Ziemniaczenka/OptiBolt-protocol-and-evaluation/doc/resources/protokół komunikacji teoria.pdf

Pamiętać że będziemy używać manchester czyli każde 0 w tym pliku to tak naprawde 01 a każde 1 to tak naprawde 10
idle: docelowo 111111, ale dekoder może sie pogubić i odbierać to jako 000000, nie ma to dla nas znaczenia bo istnieje preambuła
preambuła+bity start (6+2 bitów) 01010100
header (3 bity)
Handshake: fizyczny switch na płytce czy jest źródłem czy odbiornikiem, jeśli łączą sie 2 te same typy - przerwanie łączności.
000 - Capabilities (co ma źródło)
001 - Request (co chce odbiornik)
010 - Accept (zgoda źródła)
011 - Denied (odmowa źródła) Dane użytkowe:
100 - tekst
101 - test1
110 - test2
111 - test3
dane (8 bitów)
Handshake:
chce/daje np
0000 0001 5V 1A
0000 0010 9V 2A
0000 0100 20V 5A
Można również początkowe bity zaimplementować do negocjacji częstotliwości
Dane użytkowe:
użytkownik jest w stanie wpisać całe zdanie i potem wysyłamy to literka po literce w kodzie ASCII bit parzystości (1 bit) 0 jeśli liczba 1 parzysta, 1 jeśli nieparzysta
bit stopu (1 bit) po prostu 1
synchronizacja przy każdym bitcie bo mamy oversampling 16x, zbocze zawsze powinno być w połowie, jak nie to korygujemy
sprawdzamy w 0.2 trwania bitu i w 0.8 trwania bitu, jak mamy 1 i 0 to znaczy że 1 jak mamy 0 i 1 to znaczy że 0, jak mamy 1 i 1 albo 0 i 0 to oznacza błąd i przerwanie nadawania. Dodatkowo sprawdzamy kiedy było zbocze użytkowe które miało być około 0.5, tam gdzie ono było to jest nasze nowe 0.5
