Ziemniaczenka/OptiBolt-protocol-and-evaluation/doc/resources/raport.docx

# Tytuł: OptiBolt - Hybrydowy protokół komunikacji optycznej i platforma ewaluacyjna Autorzy: Tomasz Więcławski (TW), Sebastian Zoń (SZ)

Ostatnia modyfikacja: 30.08.2026

Spis treści

1. Repozytorium git 1

2. Wstęp 1

3. Specyfikacja 1

3.1. Opis ogólny algorytmu 1

3.2. Tabela zdarzeń 2

4. Architektura 2

4.1. Moduł: top 2

4.1.1. Schemat blokowy 2

4.1.2. Porty 3

a) mou – mouse_ctl, input 3

b) vga – vga_ctl, output 3

4.1.3. Interfejsy 3

a) m2c – mouse_ctl to core 3

4.2. Rozprowadzenie sygnału zegara 3

5. Implementacja 4

5.1. Lista zignorowanych ostrzeżeń Vivado. 4

5.2. Wykorzystanie zasobów 4

5.3. Marginesy czasowe 4

6. Film. 4

# 1. Repozytorium git

Adres repozytorium GITa:

https://github.com/Ziemniaczenka/OptiBolt-protocol-and-evaluation

W przypadku repozytorium prywatnego należy zaprosić użytkownika zewnętrznego o adresie mailowym: kaczmarczyk@agh.edu.pl

# 2. Wstęp

Celem projektu jest zaprojektowanie, implementacja i weryfikacja hybrydowego protokołu komunikacji optyczno-elektrycznej OptiBolt oraz kompletnej platformy ewaluacyjnej na układach FPGA Digilent Basys 3 (Xilinx Artix-7 XC7A35T). Protokół wykorzystuje optyczne transceivery TOSLINK (PMOD) do bezbłędnej transmisji danych o wysokiej odporności na zakłócenia elektromagnetyczne (EMI) i pełnej izolacji galwanicznej. Platforma ewaluacyjna integruje sprzętowy kontroler wideo VGA (720p 1280x720@60Hz), dekoder klawiatury USB/PS-2, interaktywne menu ekranowe, terminal CLI, testy integralności sygnału (BER, latency RTT, sweep przepływności), przesyłanie bitmap oraz emulację negocjacji zasilania (Power Delivery).

# 3. Specyfikacja

## 3.1. Opis ogólny algorytmu

Transceiver protokołu OptiBolt pracuje w domenie 200 MHz, co zapewnia precyzyjne próbkowanie (oversampling) i kodowanie sygnału w kodzie Manchester (samotaktujący strumień danych). Ramka protokołu składa się z 8-bitowej preambuły synchronizującej, 3-bitowego typu komunikatu (Dane, Komenda, Negocjacja Zasilania, Ping), 8-bitowego ładunku danych oraz bitu parzystości. Odbiornik dokonuje detekcji nośnej optycznej, synchronizacji fazowej, weryfikacji kodu Manchester oraz kontroli integralności danych. Platforma ewaluacyjna w domenie 100 MHz steruje wykonywaniem testów automatycznych, analizą błędów w czasie rzeczywistym i wyświetlaniem wyników na ekranie.

Ewentualnie przykładowe screen-shoty tego, co w przybliżeniu chcielibyśmy uzyskać.

## 3.2. Tabela zdarzeń

Opis zdarzeń występujących podczas działania programu/urządzenia, zarówno zewnętrznych (interakcje z użytkownikiem), jak i wewnętrznych (specyficzne stany w algorytmie). Zdarzenia podzielone są na kategorie dotyczące różnych stanów działania programu. Kategorie powinny odpowiadać stanom ze schematu z pkt. 2.1.

Zdarzenie | Kategoria | Reakcja systemu
Naciśnięcie strzałek (Góra/Dół/Lewo/Prawo) | Nawigacja UI | Przemieszczenie wskaźnika zaznaczenia po przyciskach paska narzędzi i polach ekranu.
Naciśnięcie Enter na przycisku Toolbar | Nawigacja UI | Uruchomienie wybranej funkcji (np. Help, Ping, Sweep, Send BMP, Clear Console/BMP).
Wpisanie tekstu i Enter w polu CLI | Terminal CLI | Przekazanie linii poleceń do interpretera, wykonanie komendy lub wysłanie wiadomości tekstowej do drugiej płytki.
Odebranie pakietu Ping Request | Protokół OptiBolt | Automatyczne wygenerowanie i odesłanie pakietu Ping Response w warstwie sprzętowej.
Odebranie pakietu Ping Response | Ewaluacja | Zatrzymanie licznika czasu, obliczenie czasu Round-Trip Time (RTT) w cyklach/mikrosekundach i wypisanie wyniku w konsoli.
Uruchomienie testu Sweep | Testy protokołu | Automatyczne przejście przez wszystkie kombinacje Baudrate i Oversampling, transmisja pakietów testowych i weryfikacja poprawności.
Wysłanie bitmapy 64x64 | Transfer danych | Odczyt pikseli z pamięci obrazu, sekwencyjna transmisja pakietów graficznych przez łącze optyczne i wizualizacja na ekranie odbiorcy.
Wykrycie zaniku/pojawienia nośnej optycznej | Warstwa fizyczna | Aktualizacja stanu diody nośnej (Carrier Detect) oraz powiadomienie modułu nadrzędnego o stanie łącza.
Wykrycie błędu (Manchester / Parzystość / Preambuła) | Diagnostyka | Inkrementacja dedykowanych liczników błędów, aktualizacja wskaźników paskowych i wyliczenie współczynnika BER.

# 4. Architektura

Uwaga: dobrze zrobiony projekt zawiera tylko moduły strukturalne (zbudowane z innych modułów) i funkcjonalne (zawierające bloki proceduralne always @). Staramy się nie generować bloków mieszających te dwa typy, o ile to możliwe (głównym kryterium powinna być czytelność kodu).

Uwaga: opisujemy architekturę tylko głównego modułu oraz rozprowadzenie sygnału zegara.

## 4.1. Moduł: top

Osoba odpowiedzialna: Tomasz Więcławski, Sebastian Zoń

### 4.1.1. Schemat blokowy

Uwaga: Schemat blokowy to nie jest schemat z Vivado! Nie zawiera on sygnałów, tylko interfejsy. Interfejs oznacza tutaj grupę sygnałów. Schemat blokowy pokazuje moduły składowe, oraz łączące je interfejsy.

Architektura modułu głównego (top.sv) integruje cztery kluczowe bloki funkcjonalne:
1. u_top_evaluation – platforma ewaluacyjna (GUI VGA 720p, PS/2, kontroler ewaluacji, pamięci BRAM),
2. u_optibolt_controller – kontroler protokołu (generator taktowania, koder/dekoder Manchester, kolejki FIFO TX/RX),
3. u_optibolt_cdc_bridge – bezpieczny most asynchroniczny (CDC) łączący domenę ewaluacji 100 MHz i domenę protokołu 200 MHz,
4. u_optical_carrier_detector – sprzętowy detektor obecności nośnej na linii optycznej RX z filtrem histerezy.
Szczegółowe schematy blokowe w formacie Mermaid znajdują się w plikach doc/schematic/top_schematic.mmd oraz doc/schematic/hardware_schematic.mmd.

Uwaga:

- interfejsy dwukierunkowe rozbijamy na 2 interfejsy jednokierunkowe
- nazwa interfejsu stanowi prefiks nazwy sygnałów składowych
- w interfejsach nie uwzględniamy sygnałów globalnych (np. clk i rst).

### 4.1.2. Porty

#### a) mou – mouse_ctl, input

nazwa portu | opis
clk | Zegar wejściowy 100 MHz z oscylatora płytki Basys 3
btnC | Przycisk resetu asynchronicznego (aktywny w stanie wysokim, negowany wewnętrznie na rst_n)
JB3 | Wejście szeregowe RX z odbiornika optycznego TOSLINK (PMOD JB, pin B15)
PS2Clk | Linia zegarowa dwukierunkowej szyny klawiatury PS/2 (z buforem trójstanowym)
PS2Data | Linia danych dwukierunkowej szyny klawiatury PS/2 (z buforem trójstanowym)

#### b) vga – vga_ctl, output

nazwa portu | opis
JB1 | Wyjście szeregowe TX do nadajnika optycznego TOSLINK (PMOD JB, pin A14)
Vsync, Hsync | Sygnały synchronizacji pionowej i poziomej standardu VGA 720p
vgaRed[3:0], vgaGreen[3:0], vgaBlue[3:0] | 12-bitowa cyfrowa szyna kolorów RGB przetwornika rezystorowego VGA
seg[6:0], an[3:0], dp | Sygnały sterujące 4-pozycyjnym 7-segmentowym wyświetlaczem LED
JA1 | Wyjście diagnostyczne lustrzanego zegara pikseli (PMOD JA)

### 4.1.3. Interfejsy

#### a) m2c – mouse_ctl to core

nazwa sygnału | opis
eval2cdc_tx_data[7:0] | Bajt danych nadawanych z platformy ewaluacyjnej do mostka CDC (100 MHz)
eval2cdc_tx_type[2:0] | Typ pakietu nadawczego (DATA, REQUEST, POWER, PING)
eval2cdc_tx_valid / full | Sygnały sterujące zapisem do asynchronicznej kolejki FIFO nadajnika
cdc2eval_rx_data[7:0] | Odebrany bajt danych przekazany z mostka CDC do ewaluacji (100 MHz)
cdc2eval_rx_type[2:0] | Typ odebranego pakietu
cdc2eval_rx_valid | Flaga ważności odebranego bajtu (strob 1-cyklowy w domenie 100 MHz)
cdc2eval_err_flags | Rozciągnięte i zsynchronizowane impulsy błędów (Manchester, Parity, Preamble)
vga_if (vcount, hcount, vsync, hsync, vblnk, hblnk, rgb) | Standaryzowany interfejs potoku generacji i nakładania warstw obrazu VGA
bram_if (addr, en, we, din, dout) | Interfejsy pamięci RAM/ROM dla bufora konsoli, czcionki, bitmapy i etykiet

## 4.2. Rozprowadzenie sygnału zegara

Osoba odpowiedzialna: Tomasz Więcławski, Sebastian Zoń

W projekcie zastosowano trzy synchronicznie powiązane domeny zegarowe wygenerowane z wbudowanych układów MMCM (Clocking Wizard):
1. 100.000 MHz (clk100) – główny zegar systemowy platformy ewaluacyjnej, kontrolera UI, konsoli i interfejsu PS/2 (wygenerowany przez clk_wiz_0),
2. 200.000 MHz (clk200) – zegar o wysokiej częstotliwości dedykowany dla transceivera OptiBolt, zapewniający precyzyjne taktowanie oversamplingu i koderów Manchester (wygenerowany przez clk_wiz_0),
3. 74.250 MHz (clk74p25) – zegar pikseli (pixel clock) zgodny ze standardem VESA 720p @ 60Hz (1280x720, wygenerowany przez clk_wiz_1).
Pomiędzy domenami 100 MHz i 200 MHz zastosowano sprzętowy mostek asynchroniczny CDC (podwójne synchronizatory cdc_sync oraz asynchroniczne kolejki async_fifo oparte na kodzie Graya).

Moduł generatora zegara umieszczamy w module głównym projektu. W pozostałych modułach używamy tylko i wyłącznie sygnały zegara wygenerowane przez ten moduł.

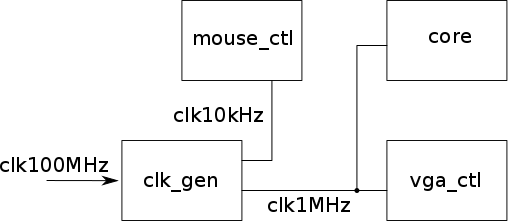
[picture p7: figure]

Uwaga: jeżeli używamy różnych częstotliwości zegara w układzie, to należy je tak dobrać, aby były wielokrotnościami siebie (umożliwia to wygenerowanie tych sygnałów z jednego IP core generatora zegara i zapobiega problemom z synchronizacją).

# 5. Implementacja

## 5.1. Lista zignorowanych ostrzeżeń Vivado.

Identyfikator ostrzeżenia | Liczba wystąpień | Uzasadnienie
Synth 8-7129 | 100 | Warning dotyczy nieużywanych portów/linii w modułach podłączonych do ustandaryzowanych interfejsów SystemVerilog (vga_if, bram_if, sampling_tick_generator). Interfejsy te grupują pełen zestaw sygnałów (koordynaty, synchronizacja, szyny danych BRAM). Poszczególne moduły wykonawcze (np. draw_string, draw_rect, draw_mux) subskrybują jedynie ten podzbiór sygnałów, który jest niezbędny do realizacji ich dedykowanej funkcji. Nieużywane linie magistrali są w sposób zamierzony i bezpieczny optymalizowane przez syntezę.
Synth 8-6014 | 26 | Rejestry buforów historii poleceń CLI oraz niewykorzystane bity struktur RAM zostały zoptymalizowane w procesie syntezy logicznej jako martwy kod (dead-code elimination). Pojemność struktur pamięciowych została zadeklarowana z marginesem na rozwój protokołu, a niewykorzystywane obszary nie generują zbędnych przerzutników.
Synth 8-3332 | 4 | Vendorowy moduł obsługi interfejsu klawiatury (Ps2Interface.vhd firmy Digilent) zawiera stany automatu FSM dedykowane do dwukierunkowej transmisji z urządzeniem PS/2. W niniejszym projekcie klawiatura pracuje wyłącznie w trybie jednokierunkowego odbioru skan-kodów (simplex RX), w związku z czym nieosiągalne stany nadawcze FSM zostały poprawnie usunięte przez syntezator.
Synth 8-5835 | 1 | Projekt deklaruje liczne tablice pamięci (bufory tekstu konsoli, czcionki ASCII, tablice parametrów). Wstępna alokacja zasobów BRAM przewyższyła dostępną liczbę dedykowanych bloków Block RAM w układzie XC7A35T (130/100). Syntezator Vivado automatycznie dokonał konwersji mniejszych pamięci stałych (ROM) do pamięci rozproszonej Distributed LUT-RAM, co pozwoliło w pełni zmieścić projekt w dostępnych zasobach FPGA.
Synth 8-330 | 25 | Interfejsy SystemVerilog (bram_if) przekazywane do modułów podrzędnych bez jawnego modportu domyślnie wnioskują połączenia dwukierunkowe (inout). Vivado poprawnie trasuje rzeczywiste kierunki przepływu danych na podstawie sterowników w modułach podrzędnych.
Opt 31-35 | 1 | Dotyczy usunięcia redundantnego bufora wejściowego IBUF z instancji clk_wiz_0. Sygnał zegarowy z pinu clk jest buforowany na poziomie top_basys3, a Vivado automatycznie eliminuje kaskadowy bufor wewnętrzny.
Power 33-332 | 1 | Wektorowa analiza poboru mocy (narzędzie Vivado Report Power) informuje o domyślnym przyjęciu stałej aktywności sygnału asynchronicznego resetu rst_n. Ostrzeżenie ma charakter czysto informacyjny dotyczący dokładności szacowania poboru mocy i nie wpływa na poprawność działania ani timingi układu FPGA.

## 5.2. Wykorzystanie zasobów

Wykorzystanie zasobów układu FPGA Xilinx Artix-7 (XC7A35T-CPG236-1) po pełnej implementacji:
• Slice LUTs: 19 927 / 20 800 (95.80%)
- LUT jako logika: 19 175 / 20 800 (92.19%)
- LUT jako Distributed RAM: 752 / 9 600 (7.83%)
• Slice Registers (Flip-Flops): 9 221 / 41 600 (22.17%)
• Block RAM (RAMB36E1/RAMB18E1): 45 / 50 płytek (90.0%)
• Układy zegarowe MMCM / PLL: 2 / 5 (40.0%)
• Bufory zegarowe (BUFG / BUFGCE): 5 / 32 (15.63%)
• Linie wejścia/wyjścia (User I/O): 28 / 106 (26.42%)

## 5.3. Marginesy czasowe

Wyniki statycznej analizy czasowej (Static Timing Analysis) po pełnym trasowaniu (Route Design):
• Setup Time Slack (WNS – Worst Negative Slack): +0.265 ns (TNS = 0.000 ns – brak naruszeń czasowych setup)
• Hold Time Slack (WHS – Worst Hold Slack): +0.020 ns (THS = 0.000 ns – brak naruszeń czasowych hold)
• Pulse Width Slack (WPWS): +1.250 ns (TPWS = 0.000 ns)
Wszystkie zdefiniowane ograniczenia czasowe dla domen 100 MHz, 200 MHz i 74.25 MHz zostały w pełni spełnione (Timing Constraints Met).

# 6. Konfiguracja sprzętu

Konfiguracja sprzętowa zestawu:
1. Połączenie optyczne: Połączenie dwóch płytek Basys 3 za pomocą dwóch przewodów światłowodowych TOSLINK (transmisja pełnodupleksowa Full-Duplex):
- Płytka 1 PMOD JB (JB1: TX) -> Światłowód 1 -> Płytka 2 PMOD JB (JB3: RX)
- Płytka 2 PMOD JB (JB1: TX) -> Światłowód 2 -> Płytka 1 PMOD JB (JB3: RX)
2. Wyświetlanie obrazu: Podłączenie monitora HDMI/VGA przez port VGA do wyjścia 720p.
3. Wprowadzanie danych: Klawiatura podłączona do portu USB HID (obsługiwana przez wbudowany kontroler PS/2).

Schematy podłączenia dodatkowych urządzeń peryferyjnych.

Konfiguracja zworek, przełączników, itp., jeśli inna niż domyślna.

# 7. Film.

Link do ściągnięcia filmu:

https://

MTM UEC2 14.04.2026 Raport z projektu, v.1.0.1 4 / 4
