Ziemniaczenka/OptiBolt-protocol-and-evaluation/doc/resources/raport_template_2025.docx

# Tytuł: OptiBolt - protocol and testbench Autorzy: Tomasz Więcławski (TW), Sebastian Zoń (SZ)

Ostatnia modyfikacja: 14.04.2026

Spis treści

1. Repozytorium git 1

2. Wstęp 1

3. Specyfikacja 1

3.1. Opis ogólny algorytmu 1

3.2. Tabela zdarzeń 2

4. Architektura 2

4.1. Moduł: top 2

4.1.1. Schemat blokowy 2

4.1.2. Porty 3

a) mou – mouse_ctl, input 3

b) vga – vga_ctl, output 3

4.1.3. Interfejsy 3

a) m2c – mouse_ctl to core 3

4.2. Rozprowadzenie sygnału zegara 3

5. Implementacja 4

5.1. Lista zignorowanych ostrzeżeń Vivado. 4

5.2. Wykorzystanie zasobów 4

5.3. Marginesy czasowe 4

6. Film. 4

# 1. Repozytorium git

Adres repozytorium GITa:

https://

W przypadku repozytorium prywatnego należy zaprosić użytkownika zewnętrznego o adresie mailowym: kaczmarczyk@agh.edu.pl

# 2. Wstęp

Skąd się wziął pomysł i co w ramach tego projektu robimy.

# 3. Specyfikacja

## 3.1. Opis ogólny algorytmu

Uproszczony schemat blokowy działania implementowanego algorytmu. Co się dzieje po starcie, jak wygląda przebieg działania, kiedy i pod jakimi warunkami się kończy.

Ewentualnie przykładowe screen-shoty tego, co w przybliżeniu chcielibyśmy uzyskać.

## 3.2. Tabela zdarzeń

Opis zdarzeń występujących podczas działania programu/urządzenia, zarówno zewnętrznych (interakcje z użytkownikiem), jak i wewnętrznych (specyficzne stany w algorytmie). Zdarzenia podzielone są na kategorie dotyczące różnych stanów działania programu. Kategorie powinny odpowiadać stanom ze schematu z pkt. 2.1.

Zdarzenie | Kategoria | Reakcja systemu
LPM w obszarze X | Ekran startowy | Uruchomienie gry
Piłka uderza w ścianę | Gra | Zmiana kierunku ruchu piłki
Piłka uderza w dół ekranu | Gra | Koniec gry

# 4. Architektura

Uwaga: dobrze zrobiony projekt zawiera tylko moduły strukturalne (zbudowane z innych modułów) i funkcjonalne (zawierające bloki proceduralne always @). Staramy się nie generować bloków mieszających te dwa typy, o ile to możliwe (głównym kryterium powinna być czytelność kodu).

Uwaga: opisujemy architekturę tylko głównego modułu oraz rozprowadzenie sygnału zegara.

## 4.1. Moduł: top

Osoba odpowiedzialna: JK

### 4.1.1. Schemat blokowy

Uwaga: Schemat blokowy to nie jest schemat z Vivado! Nie zawiera on sygnałów, tylko interfejsy. Interfejs oznacza tutaj grupę sygnałów. Schemat blokowy pokazuje moduły składowe, oraz łączące je interfejsy.

Miejsce na schemat blokowy modułu głównego

Uwaga:

- interfejsy dwukierunkowe rozbijamy na 2 interfejsy jednokierunkowe
- nazwa interfejsu stanowi prefiks nazwy sygnałów składowych
- w interfejsach nie uwzględniamy sygnałów globalnych (np. clk i rst).

### 4.1.2. Porty

#### a) mou – mouse_ctl, input

nazwa portu | opis
mou_si | szeregowe wejście danych

#### b) vga – vga_ctl, output

nazwa portu | opis
vga_vs | sygnał synchronizacji pionowej VGA

### 4.1.3. Interfejsy

#### a) m2c – mouse_ctl to core

nazwa sygnału | opis
m2c_x[9:0] | horyzontalna pozycja kursora myszy na ekranie
m2c_y[9:0] | wertykalna pozycja kursora myszy na ekranie

## 4.2. Rozprowadzenie sygnału zegara

Osoba odpowiedzialna: JK

Informacja na temat źródła sygnału zegarowego, używanych częstotliwości zegara w całym układzie.

Moduł generatora zegara umieszczamy w module głównym projektu. W pozostałych modułach używamy tylko i wyłącznie sygnały zegara wygenerowane przez ten moduł.


Uwaga: jeżeli używamy różnych częstotliwości zegara w układzie, to należy je tak dobrać, aby były wielokrotnościami siebie (umożliwia to wygenerowanie tych sygnałów z jednego IP core generatora zegara i zapobiega problemom z synchronizacją).

# 5. Implementacja

## 5.1. Lista zignorowanych ostrzeżeń Vivado.

Identyfikator ostrzeżenia | Liczba wystąpień | Uzasadnienie

## 5.2. Wykorzystanie zasobów

Tabela z wykorzystaniem zasobów z Vivado

## 5.3. Marginesy czasowe

Marginesy czasowe (WNS) dla setup i hold.

# 6. Konfiguracja sprzętu

Schemat połączenia ze sobą płytek Basys3 w trybie multiplayer.

Schematy podłączenia dodatkowych urządzeń peryferyjnych.

Konfiguracja zworek, przełączników, itp., jeśli inna niż domyślna.

# 7. Film.

Link do ściągnięcia filmu:

https://

MTM UEC2 14.04.2026 Raport z projektu, v.1.0.1 4 / 4
