Ziemniaczenka/OptiBolt-protocol-and-evaluation/doc/resources/mtm-digital-guidelines.pdf

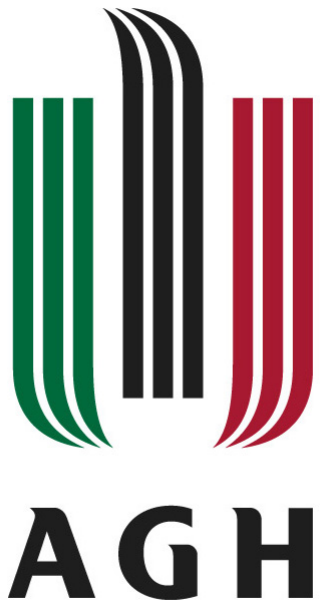
[picture p14: figure]

# Wytyczne do projektowania układów cyfrowych w języku SystemVerilog

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

d r i n ż . P a w e ł S k r z y p i e c

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

K r a k ó w , 5 p a ź d z i e r n i k a 2 0 2 5

Spis treści

### Spis treści

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

2

Spis kodów źródłowych

## Spis kodów źródłowych

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

3

### 1. Styl kodowania

## 1. Styl kodowania

### 1.1. Formatowanie ogólne

Maksymalna długość linii

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

Wcięcia

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

Ostatnia nowa linia

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

Zbędne spacje na końcu linii

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

Jednostka czasu

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

Jeden moduł / interfejs / klasa na plik

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

Jedno wyrażenie na linię

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

4

### 1. Styl kodowania

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

### 1.2. Spacje, nawiasy i operatory

Słowa kluczowe i nawiasy

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

c j e .

- P r z y k ł a d :
if (warunek)

Spacje wewnątrz nawiasów

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

Odstępy wokół operatorów

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

Spacje po przecinkach i średnikach

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

- P r z y k ł a d :
a, b

5

### 1. Styl kodowania

### 1.3. Bloki i struktura

beginend przy pojedynczym poleceniu

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

c e n i u .

- P r z y k ł a d :
if (valid) begin
++counter;
end

Styl instrukcji warunkowej ifelse

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

Styl instrukcji warunkowej case

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

c z o w e g o case.

- P r z y k ł a d :
case (state)
IDLE: begin
if (trigger) begin
state_nxt = ACTIVE;
end
end
ACTIVE: begin
state_nxt = IDLE;
end
endcase

6

### 1. Styl kodowania

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

s a n i a d o m y ś l n e .

Kolejność sekcji w module

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

1 . i m p o r t y p a k i e t ó w ,

2 . p a r a m e t r y m o d u ł u ,

3 . p o r t y m o d u ł u ,

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

5 . d e f i n i c j e t y p ó w ,

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

7 . p r z y p i s a n i a ( assign) ,

8 . i n s t a n c j e p o d m o d u ł ó w ,

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

Nazwy i etykiety bloków

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

### 1.4. Konstrukcje sekwencyjne i kombinacyjne

Specjalizowane bloki always

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

Przypisania

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

7

### 1. Styl kodowania

Sygnał zegarowy

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

Sygnał resetujący

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

Inicjalizacja rejestrów

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

### 1.5. Nazewnictwo

Stosowana notacja

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

Wielkość liter

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

8

### 1. Styl kodowania

Sufiksy

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

s u f i k s _t.

### 1.6. Literały i liczby

Szerokość literałów liczbowych

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

Separatory

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

### 1.7. Moduły, porty, parametry, instancje

Format listy portów

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

Kolejność portów

1 . Z e g a r ,

2 . R e s e t ,

3 . W y j ś c i a ,

4 . W e j ś c i a .

9

### 1. Styl kodowania

Parametry

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

Instancje

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

n y c h .

- P r z y k ł a d :
my_module u_my_module (
.clk,
.rst_n,

.din(rdata)
);

Testowany moduł

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

### 1.8. Pakiety i importy

Wykorzystywanie pakietów

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

p a k i e t ó w .

Importowanie zawartości pakietów

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

- P r z y k ł a d :
module alu
import core_pkg::*;
(

### 1.9. Komentarze i dokumentacja

1 0

### 1. Styl kodowania

Komentarze

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

k o m e n t a r z a b l o k o w e g o /* */.

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

### 1.10. Maszyny stanów skończonych

Definiowanie stanów FSM

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

t y p u w y l i c z e n i o w e g o .

- P r z y k ł a d :
typedef enum logic {
IDLE,
ACTIVE
} state_t;

state_t state, state_nxt;

Rozdzielanie logiki sekwencyjnej i kombinacyjnej

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

1 1

### 1. Styl kodowania

### 1.11. Organizacja projektu

Struktura repozytorium

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

– rtl p l i k i s y n t e z o w a l n e ,

– sim p l i k i s y m u l a c y j n e .

1 2

### 2. Przykładowe układy cyfrowe

## 2. Przykładowe układy cyfrowe

### 2.1. Bramki logiczne

Przykładowy moduł

List. 2.1 Moduł bramki and2.
/* Copyright (C) 2025 AGH University of Krakow */

module and2 (
output logic y,
input logic a,
input logic b
);

/* Signals assignments */

assign y = a & b;

endmodule

1 3

### 2. Przykładowe układy cyfrowe

Przykładowa symulacja

List. 2.2 Test modułu bramki and2.
/* Copyright (C) 2025 AGH University of Krakow */

module tb_and2;

/* Local variables and signals */

logic y, a, b;

/* Submodules placement */

and2 dut (
.y,
.a,
.b
);

/* Test */

initial begin
a = 1'b0;
b = 1'b0;

for (int i = 0; i < 4; ++i) begin a = i[0];
b = i[1];
#1;

assert (y == (a & b)) else
$error("y: exp: 0b%b, rcv: 0b%b", a & b, y); end

$finish;
end

endmodule

1 4

### 2. Przykładowe układy cyfrowe

Zadania

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

( a ) o r 2 ,

( b ) x o r 2 ,

( c ) n a n d 2 ,

( d ) n o r 2 ,

( e ) x n o r 2 .

1 5

### 2. Przykładowe układy cyfrowe

### 2.2. Detektory zbocza

Przykładowy moduł

List. 2.3 Moduł detektora zbocza narastającego.
/* Copyright (C) 2025 AGH University of Krakow */

module rising_edge_detector (
input logic clk,
input logic rst_n,

output logic edge_detected, input logic din
);

/* Local variables and signals */

logic din_buf;

/* Module internal logic */

always_ff @(posedge clk or negedge rst_n) begin if (!rst_n)
din_buf <= 1'b0;
else
din_buf <= din;
end

always_comb
edge_detected = din & ~din_buf;

endmodule

1 6

### 2. Przykładowe układy cyfrowe

Przykładowa symulacja

List. 2.4 Test modułu detektora zbocza narastającego.
/* Copyright (C) 2025 AGH University of Krakow */

module tb_rising_edge_detector;

/* Local variables and signals */

logic clk, rst_n;

logic din, edge_detected;

/* Submodules placement */

rising_edge_detector dut ( .clk,
.rst_n,

.edge_detected,
.din
);

/* Tasks and functions definitions */

task reset();
for (int i = 0; i < 2; ++i) begin @(negedge clk);
rst_n = i[0];
end
endtask

task test_constant_signal(logic val); din = val;

reset();

@(negedge clk);

assert (!edge_detected) else
$error("edge_detected: exp: 0b%b, rcv: 0b%b", 1'b0, edge_detected);

din = 1'b0;
endtask

task test_non_constant_signal(logic val); din = val;

1 7

### 2. Przykładowe układy cyfrowe

reset();

@(negedge clk);
din = ~val;
#1;

assert (edge_detected == (val == 1'b0)) else
$error("edge_detected: exp: 0b%b, rcv: 0b%b", (val == 1'b0), edge_detected);

din = 1'b0;
endtask

/* Clock generation */

initial begin
clk = 1'b0;

forever
clk = #5ns ~clk;
end

/* Test */

initial begin
rst_n = 1'b1;
din = 1'b0;

for (int i = 0; i < 2; ++i) test_constant_signal(i[0]);

for (int i = 0; i < 2; ++i) test_non_constant_signal(i[0]);

$finish;
end

endmodule

1 8

### 2. Przykładowe układy cyfrowe

Zadania

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

1 9

### 2. Przykładowe układy cyfrowe

### 2.3. Dzielniki sygnału zegarowego

Przykładowy moduł

List. 2.5 Moduł układu dzielącego częstotliwość przez 2.
/* Copyright (C) 2025 AGH University of Krakow */

module clock_divider (
input logic clk,
input logic rst_n,

output logic clk_out
);

/* Module internal logic */

always_ff @(posedge clk or negedge rst_n) begin if (!rst_n)
clk_out <= 1'b0;
else
clk_out <= ~clk_out;
end

endmodule

2 0

### 2. Przykładowe układy cyfrowe

Przykładowa symulacja

List. 2.6 Test modułu układu dzielącego częstotliwość przez 2.
/* Copyright (C) 2025 AGH University of Krakow */

module tb_clock_divider;

/* Local variables and signals */

logic clk, rst_n;

logic clk_out;

/* Submodules placement */

clock_divider dut (
.clk,
.rst_n,

.clk_out
);

/* Tasks and functions definitions */

task reset();
for (int i = 0; i < 2; ++i) begin @(negedge clk);
rst_n = i[0];
end
endtask

task test_clock_division();
reset();

for (int i = 0; i < 10; ++i) begin assert (clk_out == i[0]) else
$error("clk_out: exp: 0b%b, rcv: 0b%b", i[0], clk_out); @(negedge clk);
end
endtask

/* Clock generation */

initial begin
clk = 1'b0;

forever

2 1

### 2. Przykładowe układy cyfrowe

clk = #5ns ~clk;
end

/* Test */

initial begin
rst_n = 1'b1;

test_clock_division();

$finish;
end

endmodule

2 2

### 2. Przykładowe układy cyfrowe

Zadania

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

2 3

### 2. Przykładowe układy cyfrowe

### 2.4. Rejestry przesuwne

Przykładowy moduł

List. 2.7 Moduł rejestru przesuwającego dane w prawo.
/* Copyright (C) 2025 AGH University of Krakow */

module shift_register (
input logic clk,
input logic rst_n,

output logic dout,
input logic din
);

/* Local variables and signals */

logic [3:0] data;

/* Signals assignments */

assign dout = data[0];

/* Module internal logic */

always_ff @(posedge clk or negedge rst_n) begin if (!rst_n)
data <= 4'h0;
else
data <= {din, data[3:1]};
end

endmodule

2 4

### 2. Przykładowe układy cyfrowe

Przykładowa symulacja

List. 2.8 Test modułu rejestru przesuwającego dane w prawo..
/* Copyright (C) 2025 AGH University of Krakow */

module tb_shift_register;

/* Local variables and signals */

logic clk, rst_n;

logic din, dout;

/* Submodules placement */

shift_register dut (
.clk,
.rst_n,

.dout,
.din
);

/* Tasks and functions definitions */

task reset();
for (int i = 0; i < 2; ++i) begin @(negedge clk);
rst_n = i[0];
end
endtask

task test_data_shifting(); logic [3:0] wdata, rdata;

wdata = $random();

reset();

fork
begin
for (int i = 0; i < 4; ++i) begin @(negedge clk);
din = wdata[i];
end
end
begin
for (int i = 0; i < 4; ++i)

2 5

### 2. Przykładowe układy cyfrowe

@(negedge clk);

for (int i = 0; i < 4; ++i) begin @(negedge clk);
rdata[i] = dout;
end
end
join

assert (rdata == wdata) else
$error("rdata: exp: 0x%x, rcv: 0x%x", wdata, rdata); endtask

/* Clock generation */

initial begin
clk = 1'b0;

forever
clk = #5ns ~clk;
end

/* Test */

initial begin
rst_n = 1'b1;

test_data_shifting();

$finish;
end

endmodule

2 6

### 2. Przykładowe układy cyfrowe

Zadania

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

n y :

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

2 7

### 2. Przykładowe układy cyfrowe

### 2.5. Liczniki

Przykładowy moduł

List. 2.9 Moduł 32-bitowego licznika.
/* Copyright (C) 2025 AGH University of Krakow */

module counter (
input logic clk,
input logic rst_n,

input logic enabled,

output logic [31:0] value
);

/* Local variables and signals */

logic [31:0] value_nxt;

/* Module internal logic */

always_ff @(posedge clk or negedge rst_n) begin if (!rst_n)
value <= 32'b0;
else
value <= value_nxt;
end

always_comb begin
value_nxt = value;

if (enabled)
value_nxt = value + 1;
end

endmodule

2 8

### 2. Przykładowe układy cyfrowe

Przykładowa symulacja

List. 2.10 Test modułu 32-bitowego licznika.
/* Copyright (C) 2025 AGH University of Krakow */

module tb_counter;

/* Local variables and signals */

logic clk, rst_n;

logic [31:0] value;
logic enabled;

/* Submodules placement */

counter dut (
.clk,
.rst_n,

.enabled,

.value
);

/* Tasks and functions definitions */

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

task test_disabled_counter();
enabled = 1'b0;

reset();

for (int i = 0; i < 10; ++i) begin assert (value == 32'b0) else
$error("value: exp: %1d, rcv: %1d", 32'b0, value); @(negedge clk);
end
endtask

task test_enabled_counter(); enabled = 1'b1;

2 9

### 2. Przykładowe układy cyfrowe

reset();

for (int i = 0; i < 10; ++i) begin assert (value == i) else
$error("value: exp: %1d, rcv: %1d", i, value); @(negedge clk);
end
endtask

/* Clock generation */

initial begin
clk = 1'b0;

forever
clk = #5ns ~clk;
end

/* Test */

initial begin
rst_n = 1'b1;
enabled = 1'b0;

test_disabled_counter();
test_enabled_counter();

$finish;
end

endmodule

3 0

### 2. Przykładowe układy cyfrowe

Zadania

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

3 1

### 2. Przykładowe układy cyfrowe

### 2.6. Maszyny stanów skończonych

Przykładowy moduł

List. 2.11 Moduł przykładowej maszyny stanów skończonych.
/* Copyright (C) 2025 AGH University of Krakow */

module fsm (
input logic clk,
input logic rst_n,

output logic done,
input logic trigger
);

/* User defined types and constants */

typedef enum logic {
IDLE,
ACTIVE
} state_t;

/* Local variables and signals */

state_t state, state_nxt;
logic [3:0] counter, counter_nxt;

/* Module internal logic */

always_ff @(posedge clk or negedge rst_n) begin if (!rst_n) begin
state <= IDLE;
counter <= 4'b0;
end else begin
state <= state_nxt;
counter <= counter_nxt;
end
end

always_comb begin
state_nxt = state;
counter_nxt = counter;

case (state)
IDLE: begin
if (trigger)
state_nxt = ACTIVE;

3 2

### 2. Przykładowe układy cyfrowe

end
ACTIVE: begin
if (counter == 10) begin
state_nxt = IDLE;
counter_nxt = 4'b0;
end else begin
counter_nxt = counter + 1; end
end
endcase
end

always_comb begin
done = 1'b0;

case (state)
IDLE: ;
ACTIVE: begin
if (counter == 10)
done = 1'b1;
end
endcase
end

endmodule

3 3

### 2. Przykładowe układy cyfrowe

Przykładowa symulacja

List. 2.12 Test modułu przykładowej maszyny stanów skończonych.
/* Copyright (C) 2025 AGH University of Krakow */

module tb_fsm;

/* Local variables and signals */

logic clk, rst_n;

logic trigger, done;

/* Submodules placement */

fsm dut (
.clk,
.rst_n,

.done,
.trigger
);

/* Tasks and functions definitions */

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

task test_non_triggered_fsm();
for (int i = 0; i < 15; ++i) begin assert (!done) else
$error("done: exp: %b, rcv: %b", 1'b0, done); @(negedge clk);
end
endtask

task test_triggered_fsm(); @(negedge clk);
trigger = 1'b1;

fork
begin
@(negedge clk);
trigger = 1'b0;

3 4

### 2. Przykładowe układy cyfrowe

end
begin
for (int i = 0; i < 10; ++i) begin @(negedge clk);
assert (!done) else
$error("done: exp: %b, rcv: %b", 1'b0, done); end

@(negedge clk);
assert (done) else
$error("done: exp: %b, rcv: %b", 1'b1, done); end

join
endtask

/* Clock generation */

initial begin
clk = 1'b0;

forever
clk = #5ns ~clk;
end

/* Test */

initial begin
trigger = 1'b0;

reset();

test_non_triggered_fsm();
test_triggered_fsm();

$finish();
end

endmodule

3 5

### 2. Przykładowe układy cyfrowe

Zadania

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

3 6

### 2. Przykładowe układy cyfrowe

### 2.7. Serializery

Przykładowy moduł

List. 2.13 Moduł serializera 8 do 1.
/* Copyright (C) 2025 AGH University of Krakow */

module serializer (
input logic clk,
input logic rst_n,

input logic wvalid,
input logic [7:0] wdata,

output logic dout
);

/* User defined types and constants */

typedef enum logic {
IDLE,
ACTIVE
} state_t;

/* Local variables and signals */

state_t state, state_nxt;
logic [2:0] counter, counter_nxt;

/* Module internal logic */

always_ff @(posedge clk or negedge rst_n) begin if (!rst_n) begin
state <= IDLE;
counter <= 3'b0;
end else begin
state <= state_nxt;
counter <= counter_nxt;
end
end

always_comb begin
state_nxt = state;
counter_nxt = counter;

case (state)
IDLE: begin

3 7

### 2. Przykładowe układy cyfrowe

if (wvalid)
state_nxt = ACTIVE;
end
ACTIVE: begin
if (counter == 7) begin
state_nxt = IDLE;
counter_nxt = 3'b0;
end else begin
counter_nxt = counter + 1; end
end
endcase
end

always_comb begin
dout = 1'b0;

case (state)
IDLE: ;
ACTIVE: begin
dout = wdata[counter];
end
endcase
end

endmodule

3 8

### 2. Przykładowe układy cyfrowe

Przykładowa symulacja

List. 2.14 Test modułu serializera 8 do 1.
/* Copyright (C) 2025 AGH University of Krakow */

module tb_serializer;

/* Local variables and signals */

logic clk, rst_n;

logic [7:0] wdata;
logic wvalid;

logic dout;

/* Submodules placement */

serializer dut (
.clk,
.rst_n,

.wvalid,
.wdata,

.dout
);

/* Tasks and functions definitions */

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

task test_data_serialization(); logic [7:0] rdata;

reset();

fork
begin
wvalid = 1'b1;
wdata = $random();

@(negedge clk);

3 9

### 2. Przykładowe układy cyfrowe

wvalid = 1'b0;
end
begin
for (int i = 0; i < 8; ++i) begin @(negedge clk);
rdata[i] = dout;
end
end
join

assert (rdata == wdata) else
$error("rdata: exp: 0x%x, rcv: 0x%x", wdata, rdata);

wdata = 8'h0;
endtask

/* Clock generation */

initial begin
clk = 1'b0;

forever
clk = #5ns ~clk;
end

/* Test */

initial begin
rst_n = 1'b1;
wvalid = 1'b0;
wdata = 8'b0;

test_data_serialization();

$finish;
end

endmodule

4 0

### 2. Przykładowe układy cyfrowe

Zadania

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

4 1

### 2. Przykładowe układy cyfrowe

### 2.8. Deserializery

Przykładowy moduł

List. 2.15 Moduł deserializera 1 do 8.
/* Copyright (C) 2025 AGH University of Krakow */

module deserializer (
input logic clk,
input logic rst_n,

output logic rvalid,
output logic [7:0] rdata,

input logic din
);

/* User defined types and constants */

typedef enum logic {
IDLE,
ACTIVE
} state_t;

/* Local variables and signals */

state_t state, state_nxt;
logic [2:0] counter, counter_nxt;

logic [7:0] rdata_nxt;
logic rvalid_nxt;

/* Module internal logic */

always_ff @(posedge clk or negedge rst_n) begin if (!rst_n) begin
state <= IDLE;
counter <= 3'b0;
end else begin
state <= state_nxt;
counter <= counter_nxt;
end
end

always_comb begin
state_nxt = state;
counter_nxt = counter;

4 2

### 2. Przykładowe układy cyfrowe

case (state)
IDLE: begin
/* start bit detection */
if (!din)
state_nxt = ACTIVE;
end
ACTIVE: begin
if (counter == 7) begin
state_nxt = IDLE;
counter_nxt = 3'b0;
end else begin
counter_nxt = counter + 1; end
end
endcase
end

always_ff @(posedge clk or negedge rst_n) begin if (!rst_n) begin
rvalid <= 1'b0;
rdata <= 8'h0;
end else begin
rvalid <= rvalid_nxt;
rdata <= rdata_nxt;
end
end

always_comb begin
rvalid_nxt = 1'b0;
rdata_nxt = rdata;

case (state)
IDLE: ;
ACTIVE: begin
rdata_nxt[counter] = din;

if (counter == 7)
rvalid_nxt = 1'b1;
end
endcase
end

endmodule

4 3

### 2. Przykładowe układy cyfrowe

Przykładowa symulacja

List. 2.16 Test modułu deserializera 1 do 8.
/* Copyright (C) 2025 AGH University of Krakow */

module tb_deserializer;

/* Local variables and signals */

logic clk, rst_n;

logic [7:0] rdata;
logic rvalid;

logic din;

/* Submodules placement */

deserializer dut (
.clk,
.rst_n,

.rvalid,
.rdata,

.din
);

/* Tasks and functions definitions */

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

task test_data_deserialization(); logic [7:0] wdata = $random();

reset();

fork
begin
din = 1'b0;

for (int i = 0; i < 8; ++i) begin @(negedge clk);

4 4

### 2. Przykładowe układy cyfrowe

din = wdata[i];
end

@(negedge clk) ;
din = 1'b1;
end
begin
for (int i = 0; i < 9; ++i) begin assert (!rvalid) else
$error("rvalid: exp: 0b%b, rcv: 0b%b", 1'b0, rvalid); @(negedge clk);
end
end
join

assert (rvalid && (rdata == wdata)) else
$error("rvalid: exp: 0b%b, rcv: 0b%b; rdata: exp: 0x%x, rcv: 0x%x", 1'b0, rvalid, wdata, rdata);
endtask

/* Clock generation */

initial begin
clk = 1'b0;

forever
clk = #5ns ~clk;
end

/* Test */

initial begin
rst_n = 1'b1;
din = 1'b1;

test_data_deserialization();

$finish;
end

endmodule

4 5

### 2. Przykładowe układy cyfrowe

Zadania

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

4 6

### 2. Przykładowe układy cyfrowe

### 2.9. Pamięci

Przykładowy moduł

List. 2.17 Moduł pamięci RAM 1024 × 32b z synchronicznym odczytem.
/* Copyright (C) 2025 AGH University of Krakow */

module ram (
input logic clk,

output logic [31:0] rdata,
input logic [11:0] address, input logic we,
input logic [31:0] wdata
);

/* Local variables and signals */

logic [31:0] mem [1024];

/* Module internal logic */

always_ff @(posedge clk) begin if (we)
mem[address[11:2]] <= wdata;

rdata <= mem[address[11:2]]; end

endmodule

4 7

### 2. Przykładowe układy cyfrowe

Przykładowa symulacja

List. 2.18 Test modułu pamięci RAM 1024 × 32b z synchronicznym odczytem.
/* Copyright (C) 2025 AGH University of Krakow */

module tb_ram;

/* Local variables and signals */

logic clk;

logic [31:0] wdata, rdata;
logic [11:0] address;
logic we;

/* Submodules placement */

ram dut (
.clk,

.rdata,
.address,
.we,
.wdata
);

/* Tasks and functions definitions */

task write(logic [11:0] addr, logic [31:0] val); @(negedge clk);
address = addr;
we = 1'b1;
wdata = val;

@(negedge clk);
address = 12'h0;
we = 1'b0;
wdata = 32'h0;
endtask

task read(output logic [31:0] val, input logic [11:0] addr); @(negedge clk);
address = addr;

@(negedge clk);
val = rdata;

4 8

### 2. Przykładowe układy cyfrowe

address = 12'h0;
endtask

task test_write();
logic [31:0] val;
logic [11:0] addr;

addr = $random() & ~12'h3;
val = $random();

write(addr, val);

assert (dut.mem[addr[11:2]] == val) else $error("dut.mem[%4d]: exp: 0x%x, rcv: 0x%x", addr[11:2], val, dut.mem[addr[11:2]]); endtask

task test_write_read();
logic [31:0] wval, rval;
logic [11:0] addr;

addr = $random() & ~12'h3; wval = $random();

write(addr, wval);
read(rval, addr);

assert (rval == wval) else
$error("rval: exp: 0x%x, rcv: 0x%x", wval, rval); endtask

/* Clock generation */

initial begin
clk = 1'b0;

forever
clk = #5ns ~clk;
end

/* Test */

initial begin
address = 12'h0;
we = 1'b0;
wdata = 32'h0;

test_write();
test_write_read();

$finish;

4 9

### 2. Przykładowe układy cyfrowe

end

endmodule

5 0

### 2. Przykładowe układy cyfrowe

Zadania

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

5 1
