Ziemniaczenka/OptiBolt-protocol-and-evaluation/doc/schematic/OptiBolt_transceiver/OptiBolt_transceiver.pdf

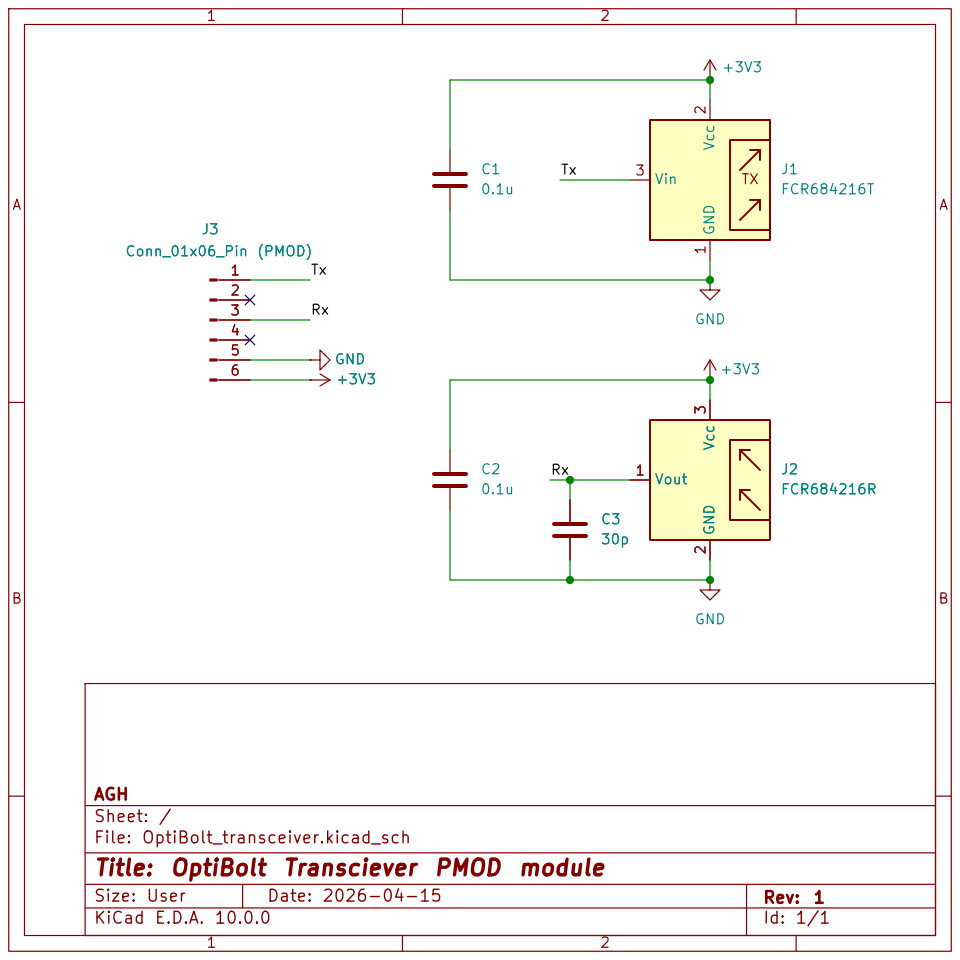
[picture p15: page 1]

AGH
Sheet: /
File: OptiBolt_transceiver.kicad_sch
Title: OptiBolt Transciever PMOD module

Size: User | Rev: 1
