Ziemniaczenka/OptiBolt-protocol-and-evaluation/doc/schematic/OptiBolt_transceiver/OptiBolt_transceiver.kicad_sch

## KiCad design doc/schematic/OptiBolt_transceiver/OptiBolt_transceiver.kicad_sch (2026-04-15)

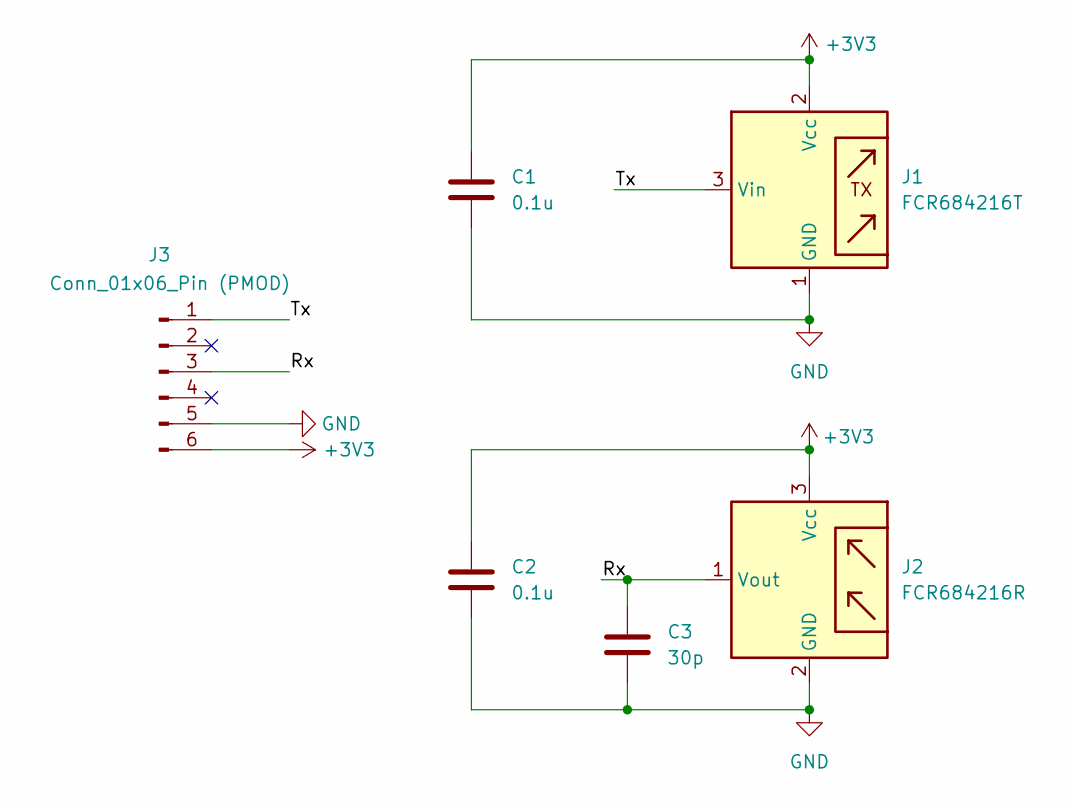
[picture p16: schematic OptiBolt_transceiver.kicad_sch]

Parts:
C1, C2: 0.1u
C3: 30p
J1: FCR684216T
J2: FCR684216R
J3: Conn_01x06_Pin (PMOD)

Connections:
+3V3: C1.1, C2.1, J1.2 (NC), J2.3 (Vcc), J3.6
GND: C1.2, C2.2, C3.2, J1.1 (GND), J2.2 (GND), J3.5
Rx: C3.1, J2.1 (Vout), J3.3
Tx: J1.3 (Vin), J3.1
