Ziemniaczenka/OptiBolt-protocol-and-evaluation/rtl/evaluation/controller/eval_cmd_pkg.sv

/**
 * Copyright (C) 2026  AGH University of Science and Technology
 * MTM UEC2
 * Author: Tomasz Wieclawski & Sebastian Zon
 *
 * Description:
 * Package for Evaluation CLI Command Execution Engine.
 * Contains text ROM arrays, sweep tables, string constants, and enum definitions.
 */

package eval_cmd_pkg;

  import ui_pkg::*;
  import protocol_pkg::*;

  // ===========================================================================
  // CLI HELP MENU ROM TEXT
  // ===========================================================================
  localparam logic [7:0] HELP_BYTES [0:535] = '{
    "/", "h", "e", "l", "p", " ", " ", " ", " ", " ", " ", " ", " ", " ", ":", " ", "S", "h", "o", "w", " ", "h", "e", "l", "p", "\n",
    "/", "p", "i", "n", "g", " ", " ", " ", " ", " ", " ", " ", " ", " ", ":", " ", "T", "e", "s", "t", " ", "R", "T", "T", "\n",
    "/", "s", "w", "e", "e", "p", " ", " ", " ", " ", " ", " ", " ", " ", ":", " ", "T", "e", "s", "t", " ", "b", "a", "u", "d", " ", "c", "o", "n", "f", "i", "g", "s", "\n",
    "/", "b", "a", "u", "d", " ", "<", "s", "p", "d", ">", " ", " ", " ", ":", " ", "1", "0", "0", "k", ",", " ", "1", "m", ",", " ", "1", ".", "2", "5", "m", ",", " ", "2", ".", "5", "m", ",", "\n",
    " ", " ", "3", ".", "1", "2", "5", "m", ",", " ", "5", "m", ",", " ", "6", ".", "2", "5", "m", ",", " ", "8", ".", "3", "3", "m", ",", " ", "1", "2", ".", "5", "m", ",", " ", "2", "5", "m", "\n",
    "/", "o", "s", " ", "<", "8", "x", " ", "|", " ", "1", "6", "x", ">", ":", " ", "S", "e", "t", " ", "o", "v", "e", "r", "s", "a", "m", "p", "l", "i", "n", "g", "\n",
    "/", "b", "i", "t", "m", "a", "p", " ", "s", "e", "n", "d", " ", " ", ":", " ", "S", "t", "r", "e", "a", "m", " ", "B", "M", "P", "\n",
    "/", "b", "i", "t", "m", "a", "p", " ", "c", "l", "e", "a", "r", " ", ":", " ", "C", "l", "e", "a", "r", " ", "B", "M", "P", "\n",
    "/", "f", "a", "i", "l", "o", "v", "e", "r", " ", "o", "n", " ", "|", " ", "o", "f", "f", " ", ":", " ", "F", "a", "i", "l", "o", "v", "e", "r", " ", "m", "o", "d", "e", "\n",
    "/", "c", "l", "e", "a", "r", " ", " ", " ", " ", " ", " ", " ", " ", ":", " ", "C", "l", "e", "a", "r", " ", "c", "o", "n", "s", "o", "l", "e", "\n",
    "/", "p", "o", "w", "e", "r", " ", "r", "o", "l", "e", " ", "<", "w", "a", "l", "l", " ", "|", " ", "b", "a", "t", "t", "e", "r", "y", " ", "|", " ", "s", "i", "n", "k", ">", "\n",
    "/", "p", "o", "w", "e", "r", " ", "i", "n", " ", "<", "v", ">", " ", "<", "a", ">", ":", " ", "S", "e", "t", " ", "i", "n", " ", "r", "e", "q", "\n",
    "/", "p", "o", "w", "e", "r", " ", "o", "u", "t", " ", "<", "v", ">", " ", "<", "a", ">", ":", " ", "S", "e", "t", " ", "o", "u", "t", " ", "c", "a", "p", "\n",
    "/", "p", "o", "w", "e", "r", " ", "r", "e", "a", "d", "y", " ", " ", ":", " ", "A", "r", "m", " ", "n", "e", "g", "o", "t", "i", "a", "t", "i", "o", "n", "\n",
    "/", "p", "o", "w", "e", "r", " ", "o", "f", "f", " ", " ", " ", " ", ":", " ", "D", "i", "s", "a", "b", "l", "e", " ", "p", "o", "w", "e", "r", "\n",
    "/", "p", "o", "w", "e", "r", " ", "c", "l", "e", "a", "r", " ", " ", ":", " ", "R", "e", "s", "e", "t", " ", "t", "a", "b", "l", "e", "s", "\n",
    "/", "p", "o", "w", "e", "r", " ", "s", "t", "a", "t", "u", "s", " ", ":", " ", "S", "h", "o", "w", " ", "p", "o", "w", "e", "r", " ", "t", "a", "b", "l", "e", "\n"
  };
  localparam int HELP_LEN = $size(HELP_BYTES);

  // ===========================================================================
  // STATUS & NOTIFICATION MESSAGES
  // ===========================================================================
  localparam logic [7:0] PWR_OFF_BYTES [0:21] = '{
    "P", "o", "w", "e", "r", " ", "d", "i", "s", "a", "b", "l", "e", "d", " ", "(", "O", "F", "F", ")", ".", "\n"
  };
  localparam logic [7:0] PWR_ROLE_SET_BYTES [0:18] = '{
    "P", "o", "w", "e", "r", " ", "r", "o", "l", "e", " ", "u", "p", "d", "a", "t", "e", "d", "\n"
  };
  localparam logic [7:0] PWR_IN_SET_BYTES [0:23] = '{
    "P", "o", "w", "e", "r", " ", "i", "n", "p", "u", "t", " ", "r", "e", "q", "u", "i", "r", "e", "m", "e", "n", "t", "\n"
  };
  localparam logic [7:0] PWR_OUT_SET_BYTES [0:23] = '{
    "P", "o", "w", "e", "r", " ", "o", "u", "t", "p", "u", "t", " ", "c", "a", "p", "a", "b", "i", "l", "i", "t", "y", "\n"
  };
  localparam logic [7:0] PWR_CLEARED_BYTES [0:20] = '{
    "P", "o", "w", "e", "r", " ", "t", "a", "b", "l", "e", "s", " ", "c", "l", "e", "a", "r", "e", "d", "\n"
  };
  localparam logic [7:0] PWR_READY_BYTES [0:24] = '{
    "P", "o", "w", "e", "r", " ", "n", "e", "g", "o", "t", "i", "a", "t", "i", "o", "n", " ", "a", "r", "m", "e", "d", ".", "\n"
  };

  localparam logic [7:0] BAUD_SET_BYTES [0:15] = '{
    "S", "p", "e", "e", "d", " ", "u", "p", "d", "a", "t", "e", "d", ".", " ", "\n"
  };
  localparam logic [7:0] FAILOVER_ON_BYTES [0:18] = '{
    "F", "a", "i", "l", "o", "v", "e", "r", ":", " ", "E", "N", "A", "B", "L", "E", "D", " ", "\n"
  };
  localparam logic [7:0] FAILOVER_OFF_BYTES [0:18] = '{
    "F", "a", "i", "l", "o", "v", "e", "r", ":", " ", "D", "I", "S", "A", "B", "L", "E", "D", "\n"
  };
  localparam logic [7:0] FAILOVER_ALERT_BYTES [0:46] = '{
    "A", "L", "E", "R", "T", ":", " ", "F", "a", "i", "l", "o", "v", "e", "r", " ", "t", "r", "i", "g",
    "g", "e", "r", "e", "d", "!", " ", "S", "p", "e", "e", "d", " ", "d", "r", "o", "p", "p", "e", "d",
    " ", "t", "o", " ", "1", "M", "\n"
  };
  localparam logic [7:0] UNKNOWN_CMD_BYTES [0:15] = '{
    "U", "n", "k", "n", "o", "w", "n", " ", "c", "o", "m", "m", "a", "n", "d", "\n"
  };
  localparam logic [7:0] ERR_DISCONN_BYTES [0:24] = '{
    "E", "r", "r", "o", "r", ":", " ", "L", "i", "n", "k", " ", "d", "i", "s", "c", "o", "n", "n", "e", "c", "t", "e", "d", "\n"
  };
  localparam logic [7:0] ERR_OS_UNSUPPORTED_BYTES [0:44] = '{
    "E", "r", "r", "o", "r", ":", " ", "1", "6", "x", " ", "O", "S", " ", "n", "o", "t", " ", "s", "u", "p", "p", "o", "r", "t", "e", "d", " ", "a", "t", " ", "c", "u", "r", "r", "e", "n", "t", " ", "s", "p", "e", "e", "d", "\n"
  };
  localparam logic [7:0] PING_START_BYTES [0:15] = '{
    "S", "e", "n", "d", "i", "n", "g", " ", "p", "i", "n", "g", ".", ".", ".", "\n"
  };
  localparam logic [7:0] SWEEP_START_BYTES [0:26] = '{
    "S", "t", "a", "r", "t", "i", "n", "g", " ", "b", "a", "u", "d", "r", "a", "t", "e", " ", "s", "w", "e", "e", "p", ".", ".", ".", "\n"
  };
  localparam logic [7:0] SWEEP_DONE_BYTES [0:20] = '{
    "B", "a", "u", "d", " ", "s", "w", "e", "e", "p", " ", "c", "o", "m", "p", "l", "e", "t", "e", ".", "\n"
  };

  // ===========================================================================
  // BAUDRATE SWEEP TABLE & RESULT STRINGS
  // ===========================================================================
  localparam logic [7:0] SWEEP_PASS_STR[0:15][0:20] = '{
    '{" ", " ", "1", "0", "0", "k", "b", "p", "s", " ", " ", "8", "x", ":", " ", "P", "A", "S", "S", " ", "\n"},
    '{" ", " ", "1", "0", "0", "k", "b", "p", "s", " ", "1", "6", "x", ":", " ", "P", "A", "S", "S", " ", "\n"},
    '{" ", " ", "1", ".", "0", "M", "b", "p", "s", " ", " ", "8", "x", ":", " ", "P", "A", "S", "S", " ", "\n"},
    '{" ", "1", ".", "2", "5", "M", "b", "p", "s", " ", " ", "8", "x", ":", " ", "P", "A", "S", "S", " ", "\n"},
    '{" ", "1", ".", "2", "5", "M", "b", "p", "s", " ", "1", "6", "x", ":", " ", "P", "A", "S", "S", " ", "\n"},
    '{" ", " ", "2", ".", "5", "M", "b", "p", "s", " ", " ", "8", "x", ":", " ", "P", "A", "S", "S", " ", "\n"},
    '{" ", " ", "2", ".", "5", "M", "b", "p", "s", " ", "1", "6", "x", ":", " ", "P", "A", "S", "S", " ", "\n"},
    '{"3", ".", "1", "2", "5", "M", "b", "p", "s", " ", " ", "8", "x", ":", " ", "P", "A", "S", "S", " ", "\n"},
    '{"3", ".", "1", "2", "5", "M", "b", "p", "s", " ", "1", "6", "x", ":", " ", "P", "A", "S", "S", " ", "\n"},
    '{" ", " ", "5", ".", "0", "M", "b", "p", "s", " ", " ", "8", "x", ":", " ", "P", "A", "S", "S", " ", "\n"},
    '{" ", "6", ".", "2", "5", "M", "b", "p", "s", " ", " ", "8", "x", ":", " ", "P", "A", "S", "S", " ", "\n"},
    '{" ", "6", ".", "2", "5", "M", "b", "p", "s", " ", "1", "6", "x", ":", " ", "P", "A", "S", "S", " ", "\n"},
    '{" ", "8", ".", "3", "3", "M", "b", "p", "s", " ", " ", "8", "x", ":", " ", "P", "A", "S", "S", " ", "\n"},
    '{" ", "1", "2", ".", "5", "M", "b", "p", "s", " ", " ", "8", "x", ":", " ", "P", "A", "S", "S", " ", "\n"},
    '{" ", "1", "2", ".", "5", "M", "b", "p", "s", " ", "1", "6", "x", ":", " ", "P", "A", "S", "S", " ", "\n"},
    '{" ", "2", "5", ".", "0", "M", "b", "p", "s", " ", " ", "8", "x", ":", " ", "P", "A", "S", "S", " ", "\n"}
  };

  localparam logic [7:0] SWEEP_FAIL_STR[0:15][0:23] = '{
    '{" ", " ", "1", "0", "0", "k", "b", "p", "s", " ", " ", "8", "x", ":", " ", "F", "A", "I", "L", " ", "e", "r", "r", "\n"},
    '{" ", " ", "1", "0", "0", "k", "b", "p", "s", " ", "1", "6", "x", ":", " ", "F", "A", "I", "L", " ", "e", "r", "r", "\n"},
    '{" ", " ", "1", "0", "0", "k", "b", "p", "s", " ", "1", "6", "x", ":", " ", "F", "A", "I", "L", " ", "e", "r", "r", "\n"},
    '{" ", "1", ".", "2", "5", "M", "b", "p", "s", " ", " ", "8", "x", ":", " ", "F", "A", "I", "L", " ", "e", "r", "r", "\n"},
    '{" ", "1", ".", "2", "5", "M", "b", "p", "s", " ", "1", "6", "x", ":", " ", "F", "A", "I", "L", " ", "e", "r", "r", "\n"},
    '{" ", " ", "2", ".", "5", "M", "b", "p", "s", " ", " ", "8", "x", ":", " ", "F", "A", "I", "L", " ", "e", "r", "r", "\n"},
    '{" ", " ", "2", ".", "5", "M", "b", "p", "s", " ", "1", "6", "x", ":", " ", "F", "A", "I", "L", " ", "e", "r", "r", "\n"},
    '{"3", ".", "1", "2", "5", "M", "b", "p", "s", " ", " ", "8", "x", ":", " ", "F", "A", "I", "L", " ", "e", "r", "r", "\n"},
    '{"3", ".", "1", "2", "5", "M", "b", "p", "s", " ", "1", "6", "x", ":", " ", "F", "A", "I", "L", " ", "e", "r", "r", "\n"},
    '{" ", " ", "5", ".", "0", "M", "b", "p", "s", " ", " ", "8", "x", ":", " ", "F", "A", "I", "L", " ", "e", "r", "r", "\n"},
    '{" ", "6", ".", "2", "5", "M", "b", "p", "s", " ", " ", "8", "x", ":", " ", "F", "A", "I", "L", " ", "e", "r", "r", "\n"},
    '{" ", "6", ".", "2", "5", "M", "b", "p", "s", " ", "1", "6", "x", ":", " ", "F", "A", "I", "L", " ", "e", "r", "r", "\n"},
    '{" ", "8", ".", "3", "3", "M", "b", "p", "s", " ", " ", "8", "x", ":", " ", "F", "A", "I", "L", " ", "e", "r", "r", "\n"},
    '{" ", "1", "2", ".", "5", "M", "b", "p", "s", " ", " ", "8", "x", ":", " ", "F", "A", "I", "L", " ", "e", "r", "r", "\n"},
    '{" ", "1", "2", ".", "5", "M", "b", "p", "s", " ", "1", "6", "x", ":", " ", "F", "A", "I", "L", " ", "e", "r", "r", "\n"},
    '{" ", "2", "5", ".", "0", "M", "b", "p", "s", " ", " ", "8", "x", ":", " ", "F", "A", "I", "L", " ", "e", "r", "r", "\n"}
  };

  localparam logic [3:0] SWEEP_BAUD[0:15] = '{
    4'd0, 4'd0, 4'd1, 4'd2, 4'd2, 4'd3, 4'd3, 4'd4, 4'd4, 4'd5, 4'd6, 4'd6, 4'd7, 4'd8, 4'd8, 4'd9
  };
  localparam logic [3:0] SWEEP_OS[0:15]   = '{
    4'd0, 4'd1, 4'd0, 4'd0, 4'd1, 4'd0, 4'd1, 4'd0, 4'd1, 4'd0, 4'd0, 4'd1, 4'd0, 4'd0, 4'd1, 4'd0
  };

  // ===========================================================================
  // TYPES & ENUMS
  // ===========================================================================
  typedef enum logic [4:0] {
    SRC_NONE,
    SRC_ECHO,
    SRC_HELP,
    SRC_BAUD_SET,
    SRC_FAILOVER_ON,
    SRC_FAILOVER_OFF,
    SRC_FAILOVER_ALERT,
    SRC_UNKNOWN,
    SRC_ERR_DISCONN,
    SRC_ERR_OS_UNSUPPORTED,
    SRC_PING_START,
    SRC_PING_MSG,
    SRC_SWEEP_START,
    SRC_SWEEP_PASS,
    SRC_SWEEP_FAIL,
    SRC_SWEEP_DONE,
    SRC_PWR_ROLE_SET,
    SRC_PWR_IN_SET,
    SRC_PWR_OUT_SET,
    SRC_PWR_CLEARED,
    SRC_PWR_READY,
    SRC_PWR_OFF,
    SRC_PWR_STATUS,
    SRC_BMP_TX_MSG,
    SRC_BMP_RX_MSG
  } msg_src_t;

  typedef enum logic [3:0] {
    E_IDLE,
    E_PARSE_CMD,
    E_STREAM_MSG,
    E_CONVERT_BCD,
    E_PING_FMT_STEP,
    E_BMP_FMT_STEP,
    E_SWEEP_STEP,
    E_SWEEP_WAIT,
    E_SWEEP_RESTORE,
    E_BITMAP_SEND,
    E_CLEAR_BITMAP,
    E_TX_CHAT
  } exec_state_t;

endpackage
