Ziemniaczenka/OptiBolt-protocol-and-evaluation/rtl/evaluation/display/vga/vga_pkg.sv

/**
 * Copyright (C) 2025  AGH University of Science and Technology
 * MTM UEC2
 * Author: Piotr Kaczmarczyk
 * Modified by: Tomasz Więcławski & Sebastian Zoń
 *
 * Description:
 * Package with vga related constants.
 */

package vga_pkg;

  // Parameters for VGA Display 800 x 600 @ 60fps using a 40 MHz clock;
  // localparam HOR_PIXELS = 800;
  // localparam VER_PIXELS = 600;

  // localparam HOR_TOTAL_TIME  = 1056;
  // localparam HOR_BLANK_START = 800;
  // localparam HOR_BLANK_TIME  = 256;
  // localparam HOR_SYNC_START  = 840;
  // localparam HOR_SYNC_TIME   = 128;

  // localparam VER_TOTAL_TIME  = 628;
  // localparam VER_BLANK_START = 600;
  // localparam VER_BLANK_TIME  = 28;
  // localparam VER_SYNC_START  = 601;
  // localparam VER_SYNC_TIME   = 4;

  // Parameters for VGA Display 1280 x 720 @ 60fps using a 74.25 MHz clock;
  localparam HOR_PIXELS = 1280;
  localparam VER_PIXELS = 720;

  localparam HOR_TOTAL_TIME = 1650;
  localparam HOR_BLANK_START = 1280;
  localparam HOR_BLANK_TIME = 370;
  localparam HOR_SYNC_START = 1390;
  localparam HOR_SYNC_TIME = 40;

  localparam VER_TOTAL_TIME = 750;
  localparam VER_BLANK_START = 720;
  localparam VER_BLANK_TIME = 30;
  localparam VER_SYNC_START = 725;
  localparam VER_SYNC_TIME = 5;

  // Add VGA timing parameters here and refer to them in other modules.

endpackage
