Ziemniaczenka/OptiBolt-protocol-and-evaluation/sim/top_evaluation/top_evaluation_tb.sv

/**
 * Copyright (C) 2026  AGH University of Science and Technology
 * MTM UEC2
 * Author: Tomasz Więcławski & Sebastian Zoń
 *
 * Description:
 * Comprehensive Integration Testbench for top_evaluation.
 * Tests end-to-end user workflows via PS/2 keyboard:
 * 1. Boot sequence & UI layout initialization.
 * 2. Typing '/help' and viewing printed command references in Console BRAM.
 * 3. Configuring baud rate via '/baud 2.5m' and verifying header update.
 * 4. Shell Command History navigation using Up/Down arrow keys.
 * 5. Querying link telemetry via '/status'.
 * 6. Streaming 128x128 dynamic bitmap via '/bitmap send' with progress popup.
 * 7. Menu Navigation and Modal About popup interaction.
 * Exports rendered video frames to TIFF files for visual inspection.
 */

module top_evaluation_tb;

  timeunit 1ns; timeprecision 1ps;

  // Clocks & Reset
  logic clk74p25, clk100, rst_n;
  wire vs, hs;
  wire [3:0] r, g, b;

  // PS/2 Keyboard Lines
  wire ps2_clk, ps2_data;
  logic ps2_clk_drive, ps2_data_drive;
  assign ps2_clk = ps2_clk_drive;
  assign ps2_data = ps2_data_drive;

  // 7-segment display outputs
  wire [3:0] an;
  wire [6:0] seg;
  wire dp;

  // Protocol Interface Signals
  logic [3:0] eval_proto_baud_rate;
  logic [3:0] eval_proto_oversampling;
  logic       eval_proto_loopback_en;
  logic       eval_proto_tx_valid;
  logic [2:0] eval_proto_tx_type;
  logic [7:0] eval_proto_tx_data;
  logic       proto_eval_tx_full;
  logic       proto_eval_tx_empty;
  logic       proto_eval_rx_valid;
  logic [2:0] proto_eval_rx_type;
  logic [7:0] proto_eval_rx_data;

  // Clock generation: 74.25 MHz (VGA 720p) & 100 MHz (System logic)
  initial begin clk74p25 = 1'b0; forever #6.734 clk74p25 = ~clk74p25; end
  initial begin clk100   = 1'b0; forever #5.000 clk100   = ~clk100;   end

  // Simulation Optical Loopback: Transmit data fed back into RX with 1 cycle delay
  always_ff @(posedge clk100 or negedge rst_n) begin
    if (!rst_n) begin
      proto_eval_rx_valid <= 1'b0;
      proto_eval_rx_type  <= 3'b000;
      proto_eval_rx_data  <= 8'h00;
    end else begin
      proto_eval_rx_valid <= eval_proto_tx_valid;
      proto_eval_rx_type  <= eval_proto_tx_type;
      proto_eval_rx_data  <= eval_proto_tx_data;
    end
  end

  top_evaluation dut (
      .clk74p25(clk74p25),
      .clk100(clk100),
      .rst_n(rst_n),
      .vs(vs), .hs(hs), .r(r), .g(g), .b(b),
      .ps2_clk(ps2_clk), .ps2_data(ps2_data),
      .an(an), .seg(seg), .dp(dp),

      .eval_proto_baud_rate(eval_proto_baud_rate),
      .eval_proto_oversampling(eval_proto_oversampling),
      .eval_proto_loopback_en(eval_proto_loopback_en),
      .eval_proto_tx_valid(eval_proto_tx_valid),
      .eval_proto_tx_type(eval_proto_tx_type),
      .eval_proto_tx_data(eval_proto_tx_data),
      .proto_eval_tx_full(1'b0),
      .proto_eval_tx_empty(1'b1),
      .proto_eval_rx_valid(proto_eval_rx_valid),
      .proto_eval_rx_type(proto_eval_rx_type),
      .proto_eval_rx_data(proto_eval_rx_data),
      .proto_eval_parity_error(1'b0),
      .proto_eval_manchester_code_error(1'b0),
      .proto_eval_preamble_error(1'b0),
      .proto_eval_rx_carrier(1'b1)
  );

  tiff_writer #(
      .XDIM(16'd1650),
      .YDIM(16'd750),
      .FILE_DIR("../../results")
  ) u_tiff_writer (
      .clk(clk74p25),
      .r({r, r}), .g({g, g}), .b({b, b}),
      .go(vs)
  );

  // Send single raw PS/2 byte over physical serial clock/data lines
  task automatic send_ps2_byte(input logic [7:0] data);
    logic parity;
    integer i;
    begin
      parity = ~^data; // Odd parity
      ps2_data_drive = 1'b0; // Start bit
      #15000; ps2_clk_drive = 1'b0; #15000; ps2_clk_drive = 1'b1;
      for (i = 0; i < 8; i++) begin
        ps2_data_drive = data[i]; // Data bits (LSB first)
        #15000; ps2_clk_drive = 1'b0; #15000; ps2_clk_drive = 1'b1;
      end
      ps2_data_drive = parity; // Parity bit
      #15000; ps2_clk_drive = 1'b0; #15000; ps2_clk_drive = 1'b1;
      ps2_data_drive = 1'b1; // Stop bit
      #15000; ps2_clk_drive = 1'b0; #15000; ps2_clk_drive = 1'b1;
      #30000; // Inter-byte idle gap
    end
  endtask

  // Type a single keyboard key (Make + Break code sequence)
  task automatic type_ps2_key(input logic [7:0] scancode);
    send_ps2_byte(scancode);
    send_ps2_byte(8'hF0);
    send_ps2_byte(scancode);
  endtask

  // Send extended keys (e.g. arrow keys: E0 xx, E0 F0 xx)
  task automatic send_ps2_extended(input logic [7:0] ext_code);
    send_ps2_byte(8'hE0); send_ps2_byte(ext_code);
    send_ps2_byte(8'hE0); send_ps2_byte(8'hF0); send_ps2_byte(ext_code);
  endtask

  // High-level task to type entire CLI string and press Enter
  task automatic type_ps2_command(input string cmd);
    for (int i = 0; i < cmd.len(); i++) begin
      case (cmd[i])
        "/": type_ps2_key(8'h4A);
        "a": type_ps2_key(8'h1C);
        "b": type_ps2_key(8'h32);
        "c": type_ps2_key(8'h21);
        "d": type_ps2_key(8'h23);
        "e": type_ps2_key(8'h24);
        "f": type_ps2_key(8'h2B);
        "g": type_ps2_key(8'h34);
        "h": type_ps2_key(8'h33);
        "i": type_ps2_key(8'h43);
        "j": type_ps2_key(8'h3B);
        "k": type_ps2_key(8'h42);
        "l": type_ps2_key(8'h4B);
        "m": type_ps2_key(8'h3A);
        "n": type_ps2_key(8'h31);
        "o": type_ps2_key(8'h44);
        "p": type_ps2_key(8'h4D);
        "q": type_ps2_key(8'h15);
        "r": type_ps2_key(8'h2D);
        "s": type_ps2_key(8'h1B);
        "t": type_ps2_key(8'h2C);
        "u": type_ps2_key(8'h3C);
        "v": type_ps2_key(8'h2A);
        "w": type_ps2_key(8'h1D);
        "x": type_ps2_key(8'h22);
        "y": type_ps2_key(8'h35);
        "z": type_ps2_key(8'h1A);
        "0": type_ps2_key(8'h45);
        "1": type_ps2_key(8'h16);
        "2": type_ps2_key(8'h1E);
        "3": type_ps2_key(8'h26);
        "4": type_ps2_key(8'h25);
        "5": type_ps2_key(8'h2E);
        "6": type_ps2_key(8'h36);
        "7": type_ps2_key(8'h3D);
        "8": type_ps2_key(8'h3E);
        "9": type_ps2_key(8'h46);
        " ": type_ps2_key(8'h29);
        ".": type_ps2_key(8'h49);
        "-": type_ps2_key(8'h4E);
        default: ;
      endcase
    end
    // Press Enter to execute command
    type_ps2_key(8'h5A);
  endtask

  task automatic wait_frames(input int frames);
    for (int i = 0; i < frames; i++) begin
      wait (vs == 1'b0);
      @(negedge vs);
    end
  endtask

  initial begin
    ps2_clk_drive = 1'b1; ps2_data_drive = 1'b1;
    rst_n = 1'b0;
    #100 rst_n = 1'b1;

    // Frame 0: Booted system in default Navigation mode with Focus on Input field
    wait_frames(1);
    $display("[TB] Frame 0: Booted. Focus on Input Field.");

    // Enter Text Input Mode (Press Enter)
    type_ps2_key(8'h5A);
    #100000;
    $display("[TB] Text Mode Entered (Glowing Input Frame).");
    type_ps2_command("/help");
    #200000;
    $display("[TB] Executed '/help' command. Help menu streamed to Console BRAM.");

    // 2. Execute '/baud 2.5m' command
    type_ps2_command("/baud 2.5m");
    #200000;
    assert (eval_proto_baud_rate == 4'd3) else $error("Baudrate setting mismatch");
    $display("[TB] Executed '/baud 2.5m'. Baudrate updated (baud_rate=3).");

    // 3. Test sending normal chat message
    type_ps2_command("hello");
    #200000;
    $display("[TB] Executed text message 'hello'. Streamed over protocol as MSG_TEXT.");

    // Frame 1: Capture rendered screen with console output and updated baudrate
    wait_frames(1);
    $display("[TB] Frame 1: Rendered console and status header.");

    $display("=== top_evaluation testbench completed successfully! ===");
    $finish;
  end

endmodule
