Ziemniaczenka/OptiBolt-protocol-and-evaluation/(commit log)

2026-04-14 update documentation, add first flowchart
2026-04-15 Add electrical schematic (from Kicad)
    [OptiBolt_transceiver.kicad_pcb, OptiBolt_transceiver.kicad_sch]
2026-04-20 update testbenches, fix one of the bugs
    [font.sv, top_display_tb.sv]
2026-05-13 protocol_pkg added, baud_rate_generator changed into sampling_tick_generator and fixed
    [list_ch04_11_mod_m_counter.v, protocol_pkg.sv, sampling_tick_generator.sv]
2026-05-20 protocol_pkg width mismatch fixed
    [protocol_pkg.sv]
2026-06-05 added rx tx test on pi pico
2026-06-07 fixed transmitter to work with fifo
    [optibolt_transmitter.sv]
2026-06-09 draw progress bar fixed, added testbench
    [draw_progress_bar.sv, draw_progress_bar_tb.sv]
2026-08-26 changes to the visual layout, new logo, many bugs
    [async_fifo.sv, bitmap_pkg.sv, draw_bg.sv, draw_bitmap.sv, draw_bitmap_tb.sv, draw_dyn_bitmap_tb.sv, draw_popup.sv, draw_progress_bar.sv]
2026-08-27 refactor of evaluation controller, many bugs
    [eval_cli_input.sv, eval_cli_input_tb.sv, eval_cmd_exec.sv, eval_cmd_exec_tb.sv, eval_console_buffer.sv, eval_console_buffer_tb.sv, eval_diagnostics.sv, eval_diagnostics_tb.sv]
2026-08-27 speed and negotation changes and fixes
    [optibolt_controller_tb.sv, optibolt_link_manager.sv, protocol_pkg.sv]
2026-08-28 fix many bugs in evaluation
    [eval_cli_input.sv, eval_cmd_exec.sv, evaluation_controller.sv, evaluation_system_tb.sv, link_handshake.sv, optibolt_link_manager.sv, protocol_pkg.sv, sampling_tick_generator.sv]
2026-08-28 added power negotiation, update testbenches, cosmetic updates
2026-08-29 fix bugs in sweep and highh speed, 12.5Mbps working
    [async_fifo.sv, dual_device_tb.sv, eval_cli_input.sv, eval_cli_input_tb.sv, eval_cmd_exec.sv, evaluation_controller.sv, evaluation_controller_tb.sv, link_handshake.sv]
2026-08-29 fixed sweep and baud negotiation between two boards
    [async_fifo.sv, dual_device_tb.sv, eval_cmd_exec.sv, evaluation_controller.sv, link_handshake.sv, optibolt_cdc_bridge.sv, optibolt_controller.sv, optibolt_link_manager.sv]
2026-08-29 fixed disconnect detection, improvements in power negotiation
    [draw_popup_tb.sv, draw_string_tb.sv, dual_device_tb.sv, eval_cmd_exec.sv, evaluation_controller.sv, link_handshake.sv, pixel_prng.sv, power_negotiator.sv]
2026-08-29 fix power negotiation between 2 same devices, minor fixes
    [dual_device_tb.sv, eval_cmd_exec.sv, power_negotiator.sv, string_pkg.sv, string_rom.sv]
2026-08-30 update PRNG, added bitmap timer(WiP), fix changing oversampling
    [dual_device_tb.sv, eval_cli_input.sv, eval_cli_input_tb.sv, eval_cmd_exec.sv, eval_cmd_exec_tb.sv, eval_cmd_pkg.sv, evaluation_controller.sv, evaluation_controller_tb.sv]
2026-08-30 sweep issue solved, extended bitmap counter
    [eval_cmd_exec.sv, eval_cmd_exec_tb.sv]
2026-08-30 fix optibolt link manager to comply with expected behaviour
    [manchester_decoder.sv, optibolt_link_manager.sv, power_negotiator.sv]
2026-08-30 added additional schematics
2026-08-30 reorder kicad files, add mmd schematic
2026-08-30 update schematics and warning summery script
2026-09-11 fix xdc error reporting and clock groups
    [top_basys3.xdc]
